Ak-yerr/Self-Balancing-Robot-Project/Photos-&-Videos/Final_Design.jpg

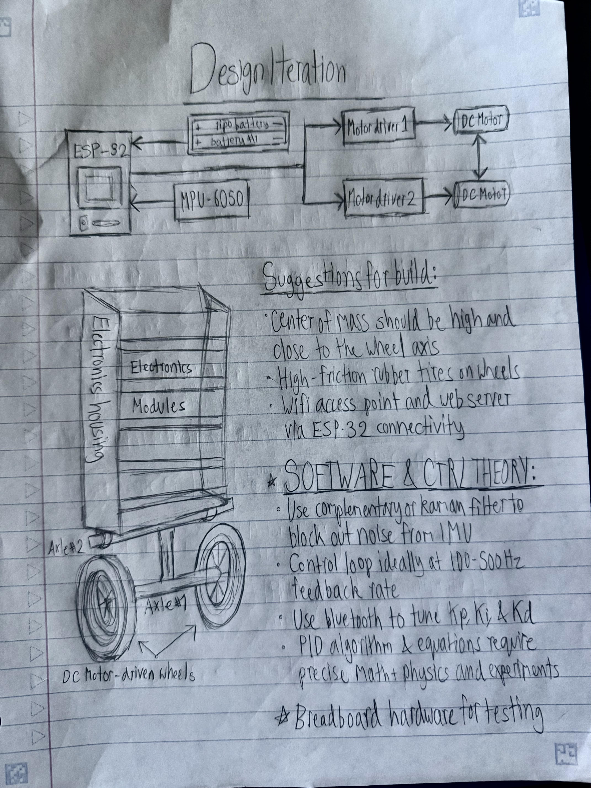
Photos-&-Videos/Final_Design.jpg
