Ak-yerr/Self-Balancing-Robot-Project/Photos-&-Videos/IMU_wiring.jpeg

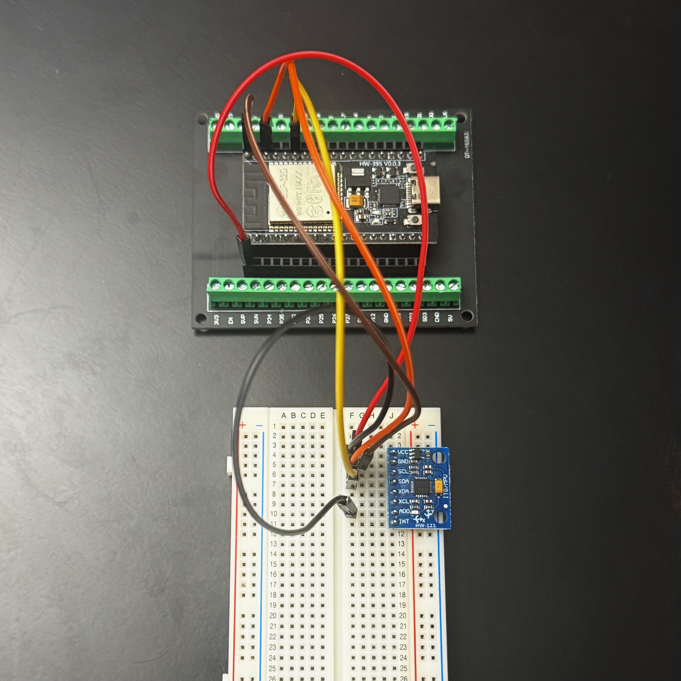
Photos-&-Videos/IMU_wiring.jpeg
