Ak-yerr/Self-Balancing-Robot-Project/Photos-&-Videos/Final_Prototype_(Isometric).jpg

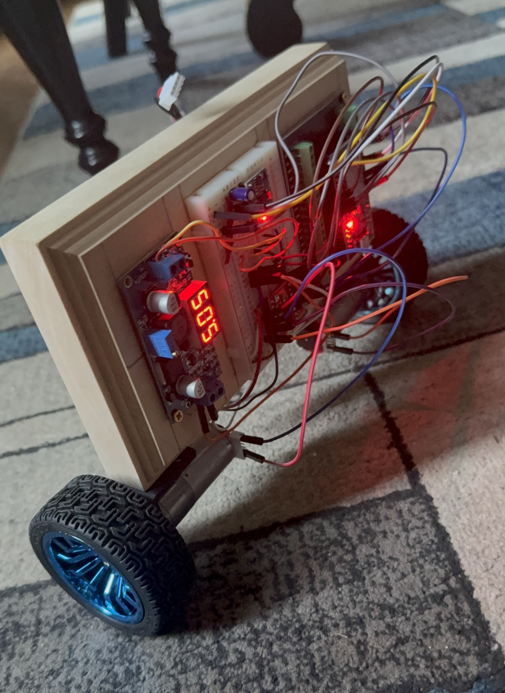
Photos-&-Videos/Final_Prototype_(Isometric).jpg
