Ak-yerr/Self-Balancing-Robot-Project/Photos-&-Videos/Prototype_3_Working.jpg

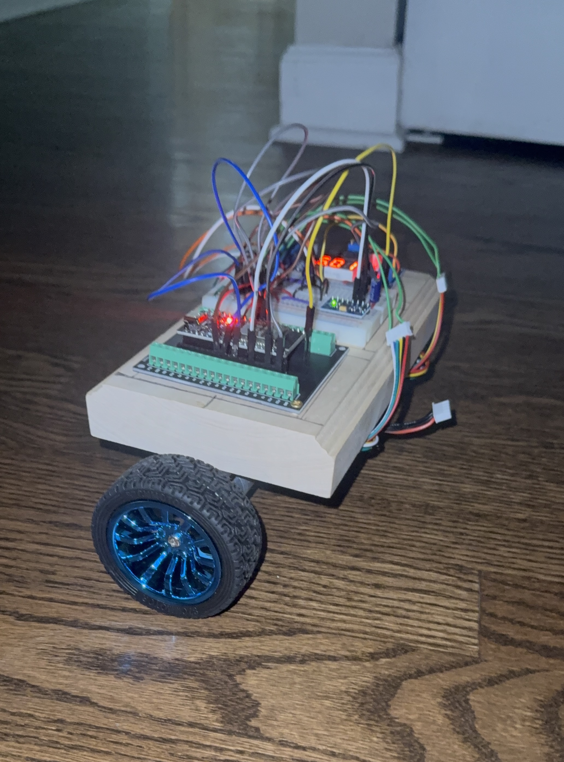
Photos-&-Videos/Prototype_3_Working.jpg
