Ak-yerr/Self-Balancing-Robot-Project/Photos-&-Videos/self_balancing_schematic_1.png

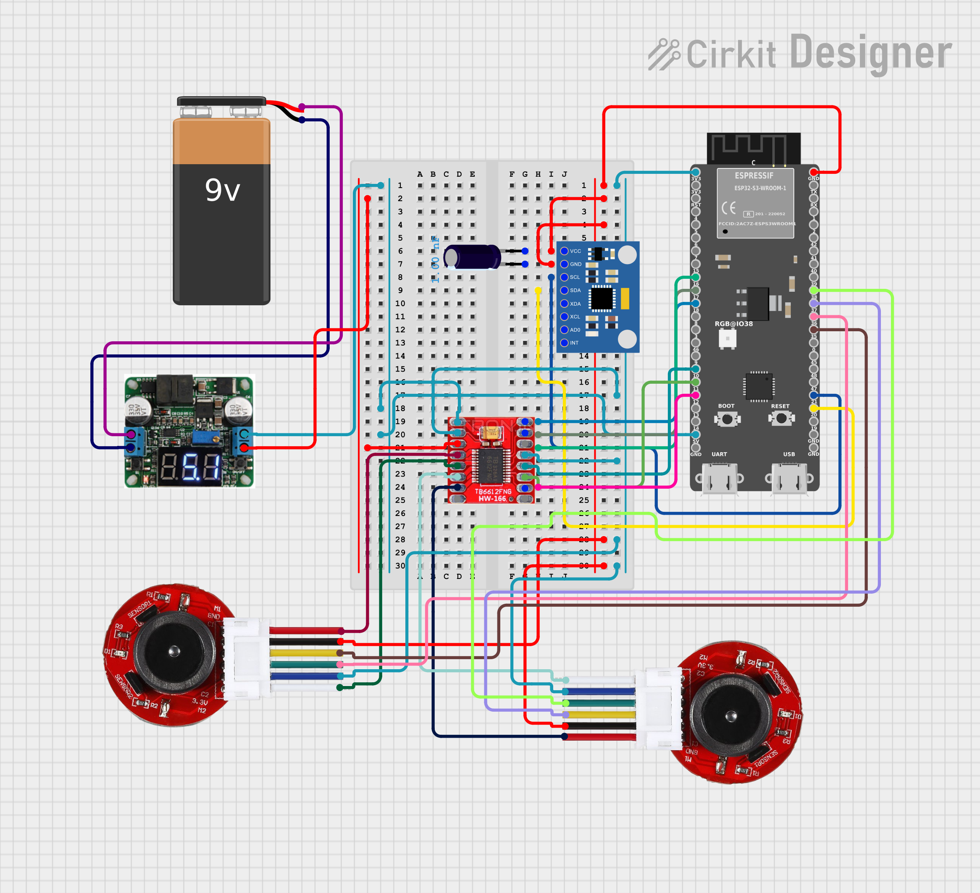
Photos-&-Videos/self_balancing_schematic_1.png
