Ak-yerr/Self-Balancing-Robot-Project/Test-Data/pid_simulation_data.csv

time_s | pitch_deg | error_deg | kp_term | kd_term | kc_term | pid_output | rpm_a | rpm_b
0.0 | 87.5001 | 5.0001 | 150.0018 | 0.0031 | 6.2502 | 156.2552 | 164.52 | -153.54
0.01 | 87.4472 | 4.9472 | 148.4165 | -2.6422 | 6.0541 | 151.8285 | 158.74 | -150.28
0.02 | 87.4808 | 4.9808 | 149.4229 | 1.6773 | 6.1781 | 157.2783 | 167.15 | -154.87
0.03 | 87.4235 | 4.9235 | 147.7048 | -2.8635 | 5.9675 | 150.8088 | 159.08 | -147.26
0.04 | 87.4308 | 4.9308 | 147.9236 | 0.3646 | 5.994 | 154.2822 | 160.6 | -151.24
0.05 | 87.4229 | 4.9229 | 147.6881 | -0.3925 | 5.9654 | 153.261 | 158.91 | -150.88
0.06 | 87.2474 | 4.7474 | 142.4219 | -8.777 | 5.3498 | 138.9947 | 144.01 | -138.98
0.07 | 87.2844 | 4.7844 | 143.5319 | 1.8501 | 5.4759 | 150.8579 | 156.5 | -147.43
0.08 | 87.2492 | 4.7492 | 142.4756 | -1.7606 | 5.3558 | 146.0708 | 153.09 | -146.92
0.09 | 87.153 | 4.653 | 139.5913 | -4.8071 | 5.0371 | 139.8213 | 146.74 | -136.85
0.1 | 87.0382 | 4.5382 | 136.1471 | -5.7404 | 4.6734 | 135.0801 | 141.12 | -133.85
0.11 | 87.0069 | 4.5069 | 135.2079 | -1.5653 | 4.5773 | 138.2199 | 146.72 | -136.67
0.12 | 86.9732 | 4.4732 | 134.196 | -1.6864 | 4.4753 | 136.985 | 145.16 | -135.12
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
