Ak-yerr/Self-Balancing-Robot-Project/Photos-&-Videos/Motors_power_test.jpeg

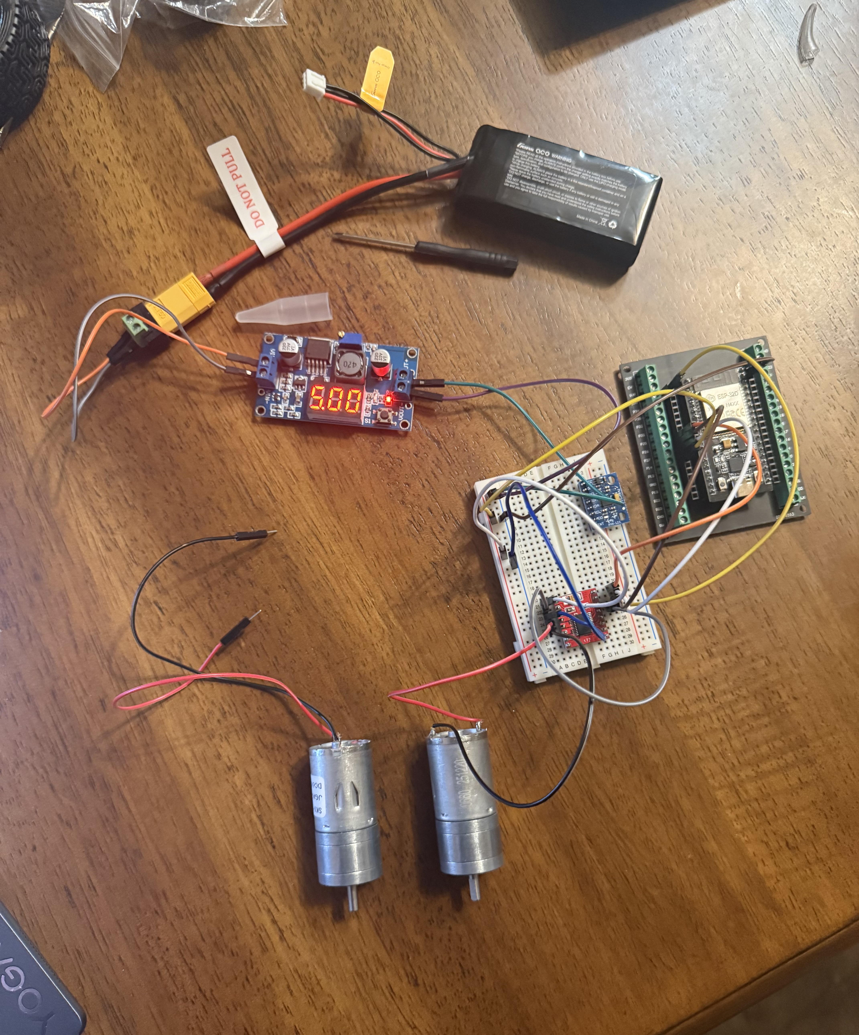
Photos-&-Videos/Motors_power_test.jpeg
