Ak-yerr/Self-Balancing-Robot-Project/Photos-&-Videos/PID_motors_encoders_testing.jpeg

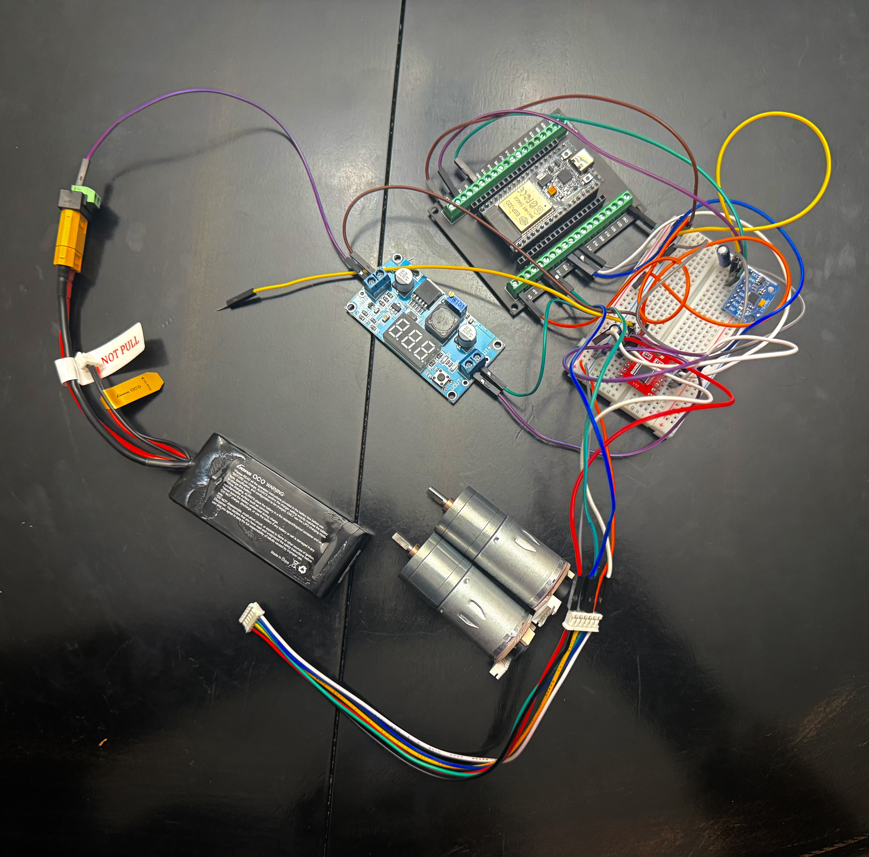
Photos-&-Videos/PID_motors_encoders_testing.jpeg
