Ak-yerr/Self-Balancing-Robot-Project/Test-Data/pid_response_chart.png

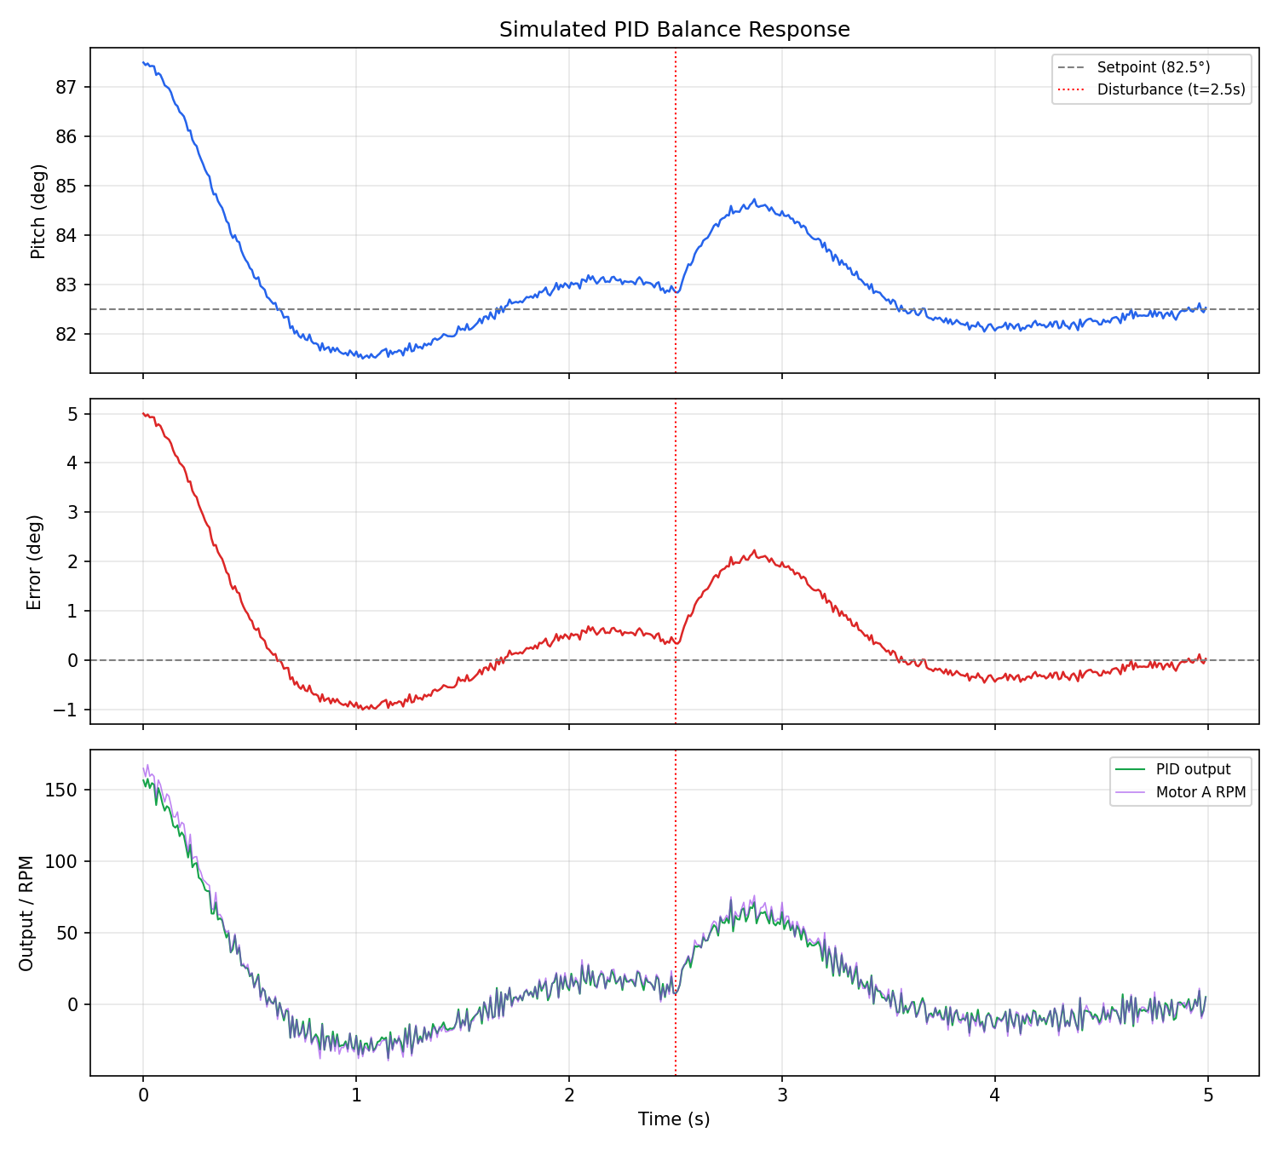
Test-Data/pid_response_chart.png
