Ak-yerr/Self-Balancing-Robot-Project/Motor-Control/PWM_direction_test.ino

// Stage 2: PWM speed ramp
// TB6612FNG + ESP32, Motor A (ESP32 core 3.x)

#define AIN1  26
#define AIN2  27
#define PWMA  25
#define STBY  14

#define PWM_FREQ       1000
#define PWM_RESOLUTION 8

void motorForward(int speed) {
  digitalWrite(AIN1, HIGH);
  digitalWrite(AIN2, LOW);
  ledcWrite(PWMA, speed);
}

void motorReverse(int speed) {
  digitalWrite(AIN1, LOW);
  digitalWrite(AIN2, HIGH);
  ledcWrite(PWMA, speed);
}

void motorStop() {
  digitalWrite(AIN1, LOW);
  digitalWrite(AIN2, LOW);
  ledcWrite(PWMA, 0);
}

void setup() {
  Serial.begin(115200);

  pinMode(AIN1, OUTPUT);
  pinMode(AIN2, OUTPUT);
  pinMode(STBY, OUTPUT);
  digitalWrite(STBY, HIGH);

  ledcAttach(PWMA, PWM_FREQ, PWM_RESOLUTION);
}

void loop() {
  Serial.println("Ramp up forward");
  for (int s = 0; s <= 255; s++) {
    motorForward(s);
    delay(10);
  }

  Serial.println("Ramp down forward");
  for (int s = 255; s >= 0; s--) {
    motorForward(s);
    delay(10);
  }

  motorStop();
  delay(500);

  Serial.println("Ramp up reverse");
  for (int s = 0; s <= 255; s++) {
    motorReverse(s);
    delay(10);
  }

  Serial.println("Ramp down reverse");
  for (int s = 255; s >= 0; s--) {
    motorReverse(s);
    delay(10);
  }

  motorStop();
  delay(1000);
}
