Ak-yerr/Self-Balancing-Robot-Project/(commit log)

2026-06-14 Testing whether the ESP32 recognizes the IMU.
2026-06-14 Code to study raw accelerometer and gyroscope data
2026-06-14 Move IMU_Testing_1.ino to IMU-Data/IMU_Testing_1.ino
2026-06-14 Move Raw_AG_Data_Test1.ino to IMU-Data/Raw_AG_Data_Test1.ino
2026-06-15 Introducing the complementary filter; reduce noise
    [Comp_Filter_Test1.ino]
2026-06-21 Added photo of how the MPU6050 is wired
2026-06-21 Move IMU_wiring.jpeg
2026-06-27 Added Motors and Battery + Buck Config.
2026-06-27 Programmed motor dir. test + PWM speed ctrl. test
2026-06-28 Added program 1 (failed functionality)
    [self_balance_1.ino]
2026-06-28 Added prototype 1 pic
2026-06-29 Added Circuit Schematic 1
2026-06-29 Added photo of encoder motors test
2026-07-11 Added Photo of Working Prototype
2026-07-12 Added Final Code for Working Prototype
2026-07-13 Added IMU Detection Verification code
2026-07-13 Added Final Prototype Front View
2026-07-13 Added Testing Data
    [pid_simulation_data.csv]
2026-07-13 Added testing code for pre-encoders iteration
