Ak-yerr/Self-Balancing-Robot-Project/Photos-&-Videos/Final_Prototype_(Front).jpg

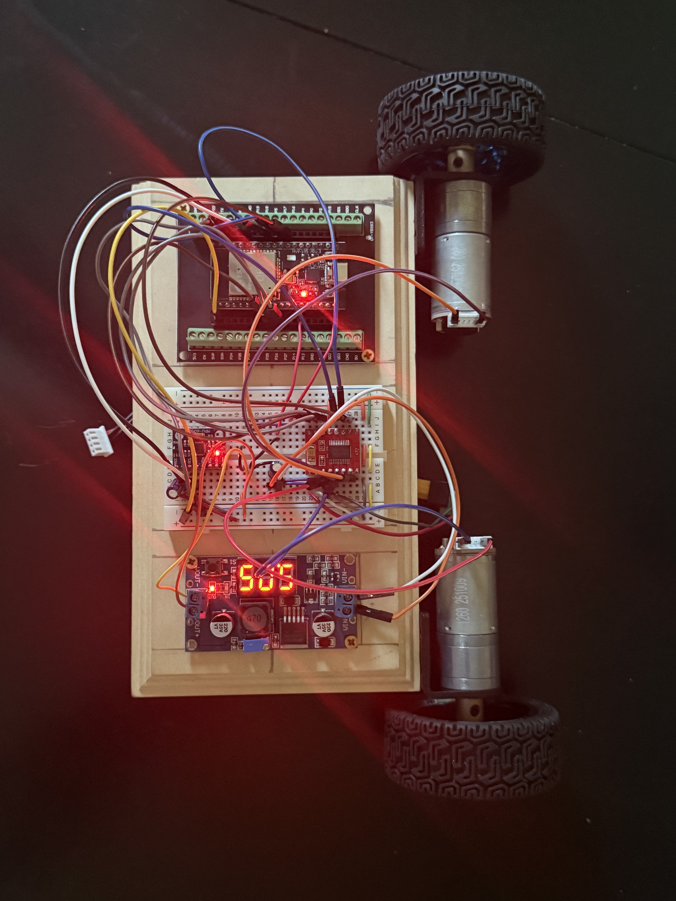
Photos-&-Videos/Final_Prototype_(Front).jpg
